ModestoHagney/zigbee-led-strip/hardware/ZigbeeLEDController/3d.step

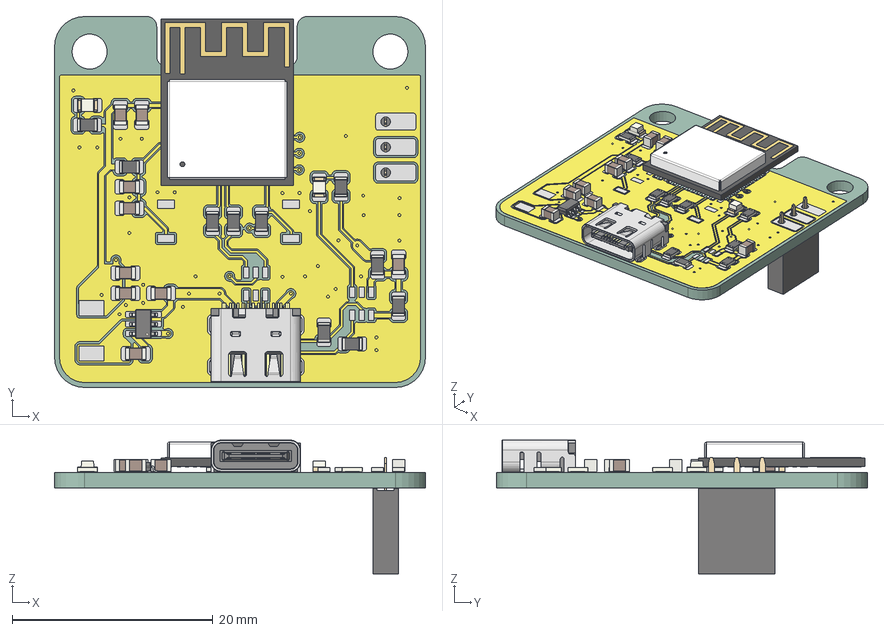
[picture p1: CAD file, 2026-10-04]
hardware/ZigbeeLEDController/3d.step
37.0 x 37.0 x 13.3 mm
LED_0805_2012Metric x 2
R_0805_2012Metric x 10
C_0805_2012Metric x 9
USB-C-SMD_G-SWITCH_GT-USB-7010ASV
TSOT-23-6
uid__2428
R0201_20210301.xtd x 3
L0201_20210301.xtd x 2
C0201_20210301.xtd x 10
ESP32-C6_QFN32_5X5_202306.xtd
XTAL3225_20210301.xtd
DFN1006.xtd
C0402_20210301.xtd
placementOutline_18
placementOutline_19
placementOutline_20
placementOutline_21
placementOutline_22
placementOutline_23
placementOutline_24
MINI-ANT-TYPE-D-H-top
MINI-ANT-TYPE-D-H-buttom
C3-MINI-solder_pad
ShieldBox_ESP32-C3-MINI-1_V1.0_20200901
PinSocket_1x03_P2.54mm_Vertical
ZigbeeLEDController_copper
ZigbeeLEDController_pad
ZigbeeLEDController_via
ZigbeeLEDController_PCB
