ModestoHagney/zigbee-led-strip/hardware/ZigbeeLEDController/ZigbeeLEDController.kicad_pcb

## KiCad design hardware/ZigbeeLEDController/ZigbeeLEDController.kicad_pcb (2026-10-04)

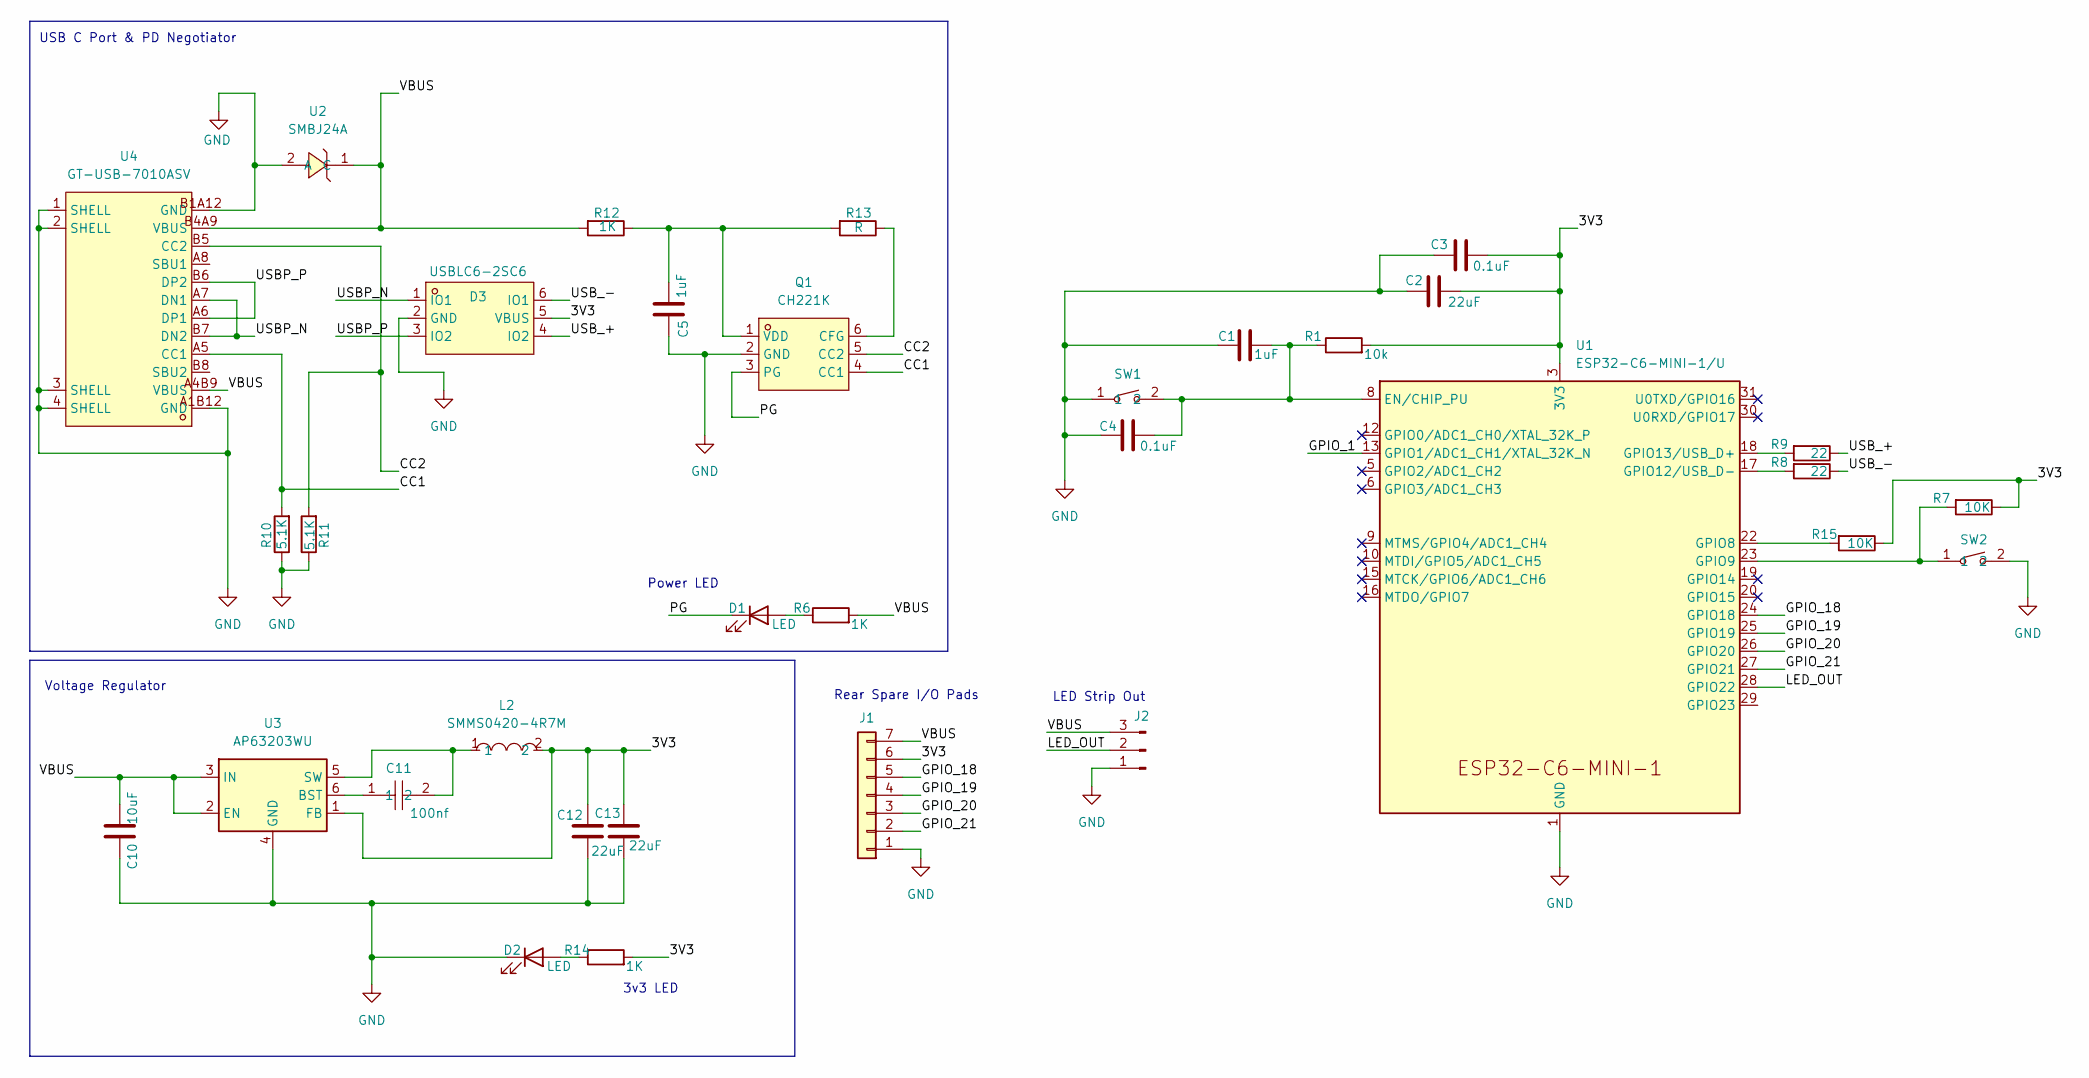
[picture p2: schematic ZigbeeLEDController.kicad_sch]

Parts:
C1, C5: 1uF; C_0805_2012Metric
C2, C12, C13: 22uF; C_0805_2012Metric
C3, C4: 0.1uF; C_0805_2012Metric
C10: 10uF; C_0805_2012Metric
C11: 100nf; C_0805_2012Metric; MPN CC0805KRX7R9BB104; LCSC Part C49678
D1, D2: LED; LED_0805_2012Metric
D3: USBLC6-2SC6; SOT-23-6_L2.9-W1.6-P0.95-LS2.8-BL; MPN USBLC6-2SC6; LCSC Part C2827654
J1: Conn_01x07; 1x07_SOLDER_PAD_1.7x4_LABEL
J2: Conn_01x03_Pin; PinSocket_1x03_P2.54mm_Vertical
L2: SMMS0420-4R7M; IND-SMD_L4.8-W4.5; MPN SMMS0420-4R7M; LCSC Part C133193
Q1: CH221K; SOT-23-6_L2.9-W1.6-P0.95-LS2.8-BL-2; MPN CH221K; LCSC Part C5125736
R1: 10k; R_0805_2012Metric
R6, R12, R14: 1K; R_0805_2012Metric
R7, R15: 10K; R_0805_2012Metric
R8, R9: 22; R_0805_2012Metric
R10, R11: 5.1K; R_0805_2012Metric
R13: R; R_0805_2012Metric
SW1, SW2: HX-B3U-1000P-1.6N; SW-SMD_2P-L3.0-W2.5-LS4.0; MPN HX-B3U-1000P-1.6N; LCSC Part C49234121
U1: ESP32-C6-MINI-1/U; ESP32-C6-MINI-1
U2: SMBJ24A; SMB_L4.3-W3.6-LS5.3-RD; MPN SMBJ24A; LCSC Part C19077578
U3: AP63203WU; TSOT-23-6
U4: GT-USB-7010ASV; USB-C-SMD_G-SWITCH_GT-USB-7010ASV; MPN GT-USB-7010ASV; LCSC Part C2988369

Connections:
/3V3: C2.2, C3.2, C12.1, C13.1, D3.5 (VBUS), J1.6, L2.2, R1.2, R7.1, R14.2, R15.1, U1.3 (3V3), U3.1 (FB)
/CC1: Q1.4 (CC1), R10.2, U4.A5 (CC1)
/CC2: Q1.5 (CC2), R11.2, U4.B5 (CC2)
/GPIO_1: U1.13 (GPIO1/ADC1_CH1/XTAL_32K_N)
/GPIO_18: J1.5, U1.24 (GPIO18)
/GPIO_19: J1.4, U1.25 (GPIO19)
/GPIO_20: J1.3, U1.26 (GPIO20)
/GPIO_21: J1.2, U1.27 (GPIO21)
/LED_OUT: J2.2, U1.28 (GPIO22)
/PG: D1.1 (K), Q1.3 (PG)
/USBP_N: D3.1 (IO1), U4.A7 (DN1), U4.B7 (DN2)
/USBP_P: D3.3 (IO2), U4.A6 (DP1), U4.B6 (DP2)
/USB_+: D3.4 (IO2), R9.1
/USB_-: D3.6 (IO1), R8.1
/VBUS: C10.1, J1.7, J2.3, R6.2, R12.2, U2.1 (C), U3.2 (EN), U3.3 (IN), U4.A4B9 (VBUS), U4.B4A9 (VBUS)
GND: C1.1, C2.1, C3.1, C4.2, C5.2, C10.2, C12.2, C13.2, D2.1 (K), D3.2 (GND), J1.1, J2.1, Q1.2 (GND), R10.1, R11.1, SW1.1, SW2.2, U1.1 (GND), U1.2 (GND), U1.11 (GND), U1.14 (GND), U1.36 (GND), U1.37 (GND), U1.38 (GND), U1.39 (GND), U1.40 (GND), U1.41 (GND), U1.42 (GND), U1.43 (GND), U1.44 (GND), U1.45 (GND), U1.46 (GND), U1.47 (GND), U1.48 (GND), U1.49 (GND), U1.50 (GND), U1.51 (GND), U1.52 (GND), U1.53 (GND), U2.2 (A), U3.4 (GND), U4.1 (SHELL), U4.2 (SHELL), U4.3 (SHELL), U4.4 (SHELL), U4.A1B12 (GND), U4.B1A12 (GND)
unnamed: D1.2 (A), R6.1
unnamed: D2.2 (A), R14.1
unnamed: Q1.6 (CFG), R13.1
unnamed: C5.1, Q1.1 (VDD), R12.1, R13.2
unnamed: C1.2, C4.1, R1.1, SW1.2, U1.8 (EN/CHIP_PU)
unnamed: R15.2, U1.22 (GPIO8)
unnamed: R7.2, SW2.1, U1.23 (GPIO9)
unnamed: R8.2, U1.17 (GPIO12/USB_D-)
unnamed: R9.2, U1.18 (GPIO13/USB_D+)
unnamed: C11.1, U3.6 (BST)
unnamed: C11.2, L2.1, U3.5 (SW)

Notes on the sheet:
LED Strip Out
Power LED
3v3 LED
USB C Port & PD Negotiator
Voltage Regulator
Rear Spare I/O Pads

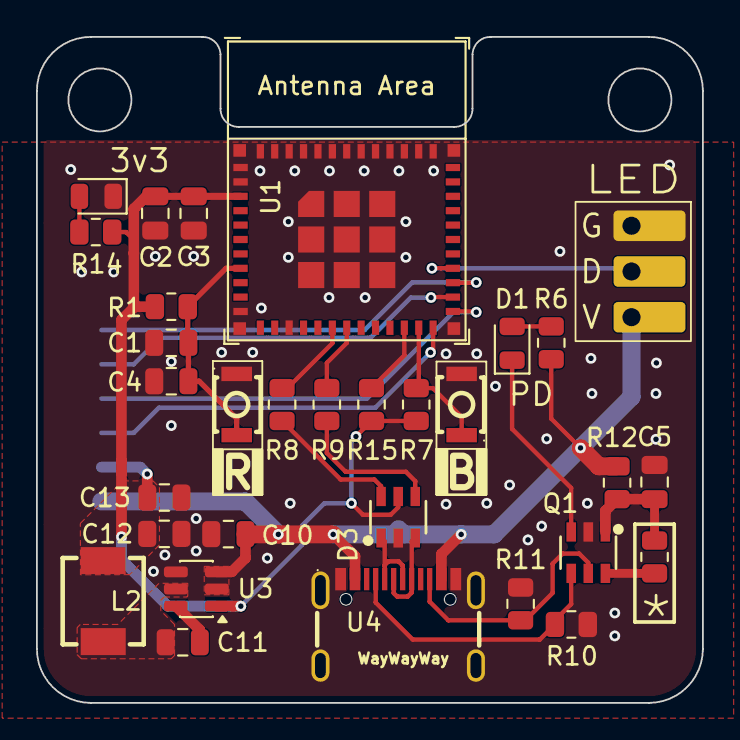
[picture p3: board ZigbeeLEDController.kicad_pcb from above]

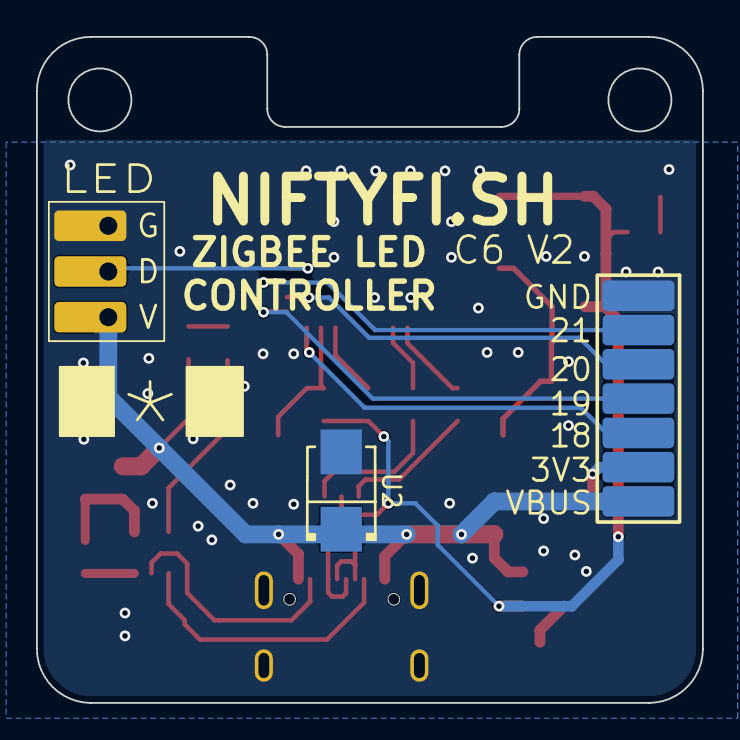
[picture p4: board ZigbeeLEDController.kicad_pcb from below]

Board: 2 copper layers, 37.0 x 37.0 mm, 33 parts (3 on the bottom side), 26 nets.
