ModestoHagney/zigbee-led-strip/(commit log)

2026-10-04 Import Zigbee LED strip firmware (ESP32-H2 copy)
    Source as it was in the local zigbee_led_h2 project folder.
2026-10-04 Build for H2 and C6 from one source
    config.h now picks the LED pin, LED count and Zigbee model name from
    the chip target, replacing the two separate project copies. Also
    renames the project to zigbee_led_strip, replaces the stock example
    README, and stops tracking the per-target dependencies.lock.
2026-10-04 Add the controller board design (KiCad)
    ESP32-C6-MINI-1 with USB-C, a CH221K USB PD sink and an LED strip
    output. Copied from the local KiCad projects folder, with the PCBWay
    fabrication zip and a STEP export; backups and caches left out.
2026-10-12 Add Home Assistant settings, fades, router mode and wireless updates
    Settings, changed from the device page in ZHA and kept in NVS: LED
    count, colour order, LED type (RGB/RGBW), max current, white balance,
    dimming curve, Zigbee transmit power, power-on behaviour and on/off
    fade time. The custom ones live in one cluster (0xFC00) and are shown
    by the quirk file in homeassistant/.
    Colour: scale the three channels together instead of clipping one,
    add white balance and a dimming curve.
    Also: the last state comes back after a power cut, Identify blinks the
    strip, chip temperature and estimated power are reported, the device
    joins as a router, and firmware can be updated over Zigbee (two app
    slo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
2026-10-12 Fix chip temperature scale and power-on setting shown in Home Assistant
    ZHA divides the device temperature by 100, so 20 degrees showed as
    0.2. The quirk file now scales it; the firmware keeps sending whole
    degrees as the Zigbee spec says.
    Power-on behaviour showed Off while the board was using "previous":
    write the values the firmware uses into the two standard settings once
    the stack is up.
    FW_VERSION 2.
2026-10-12 Quirk: cover the 4-button light and only touch firmware with settings
    Lists the 4-button bedside light under both model names it can report,
    ready for when its firmware gets the same settings cluster. A filter
    keeps the quirk off any device whose firmware doesn't have the cluster
    yet, so the 4-button light on its current firmware is left alone.
2026-10-12 Ask the coordinator for updates after joining and every hour
    Home Assistant showed the firmware version as Unknown: it learns the
    running version when the device asks about updates, and the SDK default
    is to ask once every 24 hours. Find the coordinator's update server
    once joined, ask straight away and then hourly.
2026-10-12 Quirk: animation dropdown for each button LED of the 4-button light
    Adds the full list of animation names now (Steady, Breathe, Blink,
    Heartbeat, Chase, Alternate, Rainbow, Candle, Countdown, Strobe) so the
    firmware can gain animations later without this file changing.
2026-10-12 Keep the last brightness when the stack writes a level of 0
    Switching a light off makes the Zigbee stack drop its level to 0, and
    it hands the same 0 back on the next switch-on. The firmware took that
    as the brightness, saved it, and after a restart the light came on but
    stayed dark until a brightness was set by hand. A level of 0 is now
    ignored, and a saved 0 is replaced when the state is loaded.
    FW_VERSION 3.
2026-10-12 Publish updates through a firmware branch that Home Assistant reads
    tools/make_index.py writes the index ZHA downloads. The README now
    describes the GitHub route for wireless updates.
